TileParts/0102-TILEDAP/0102-TILEDAP_SCH.pdf

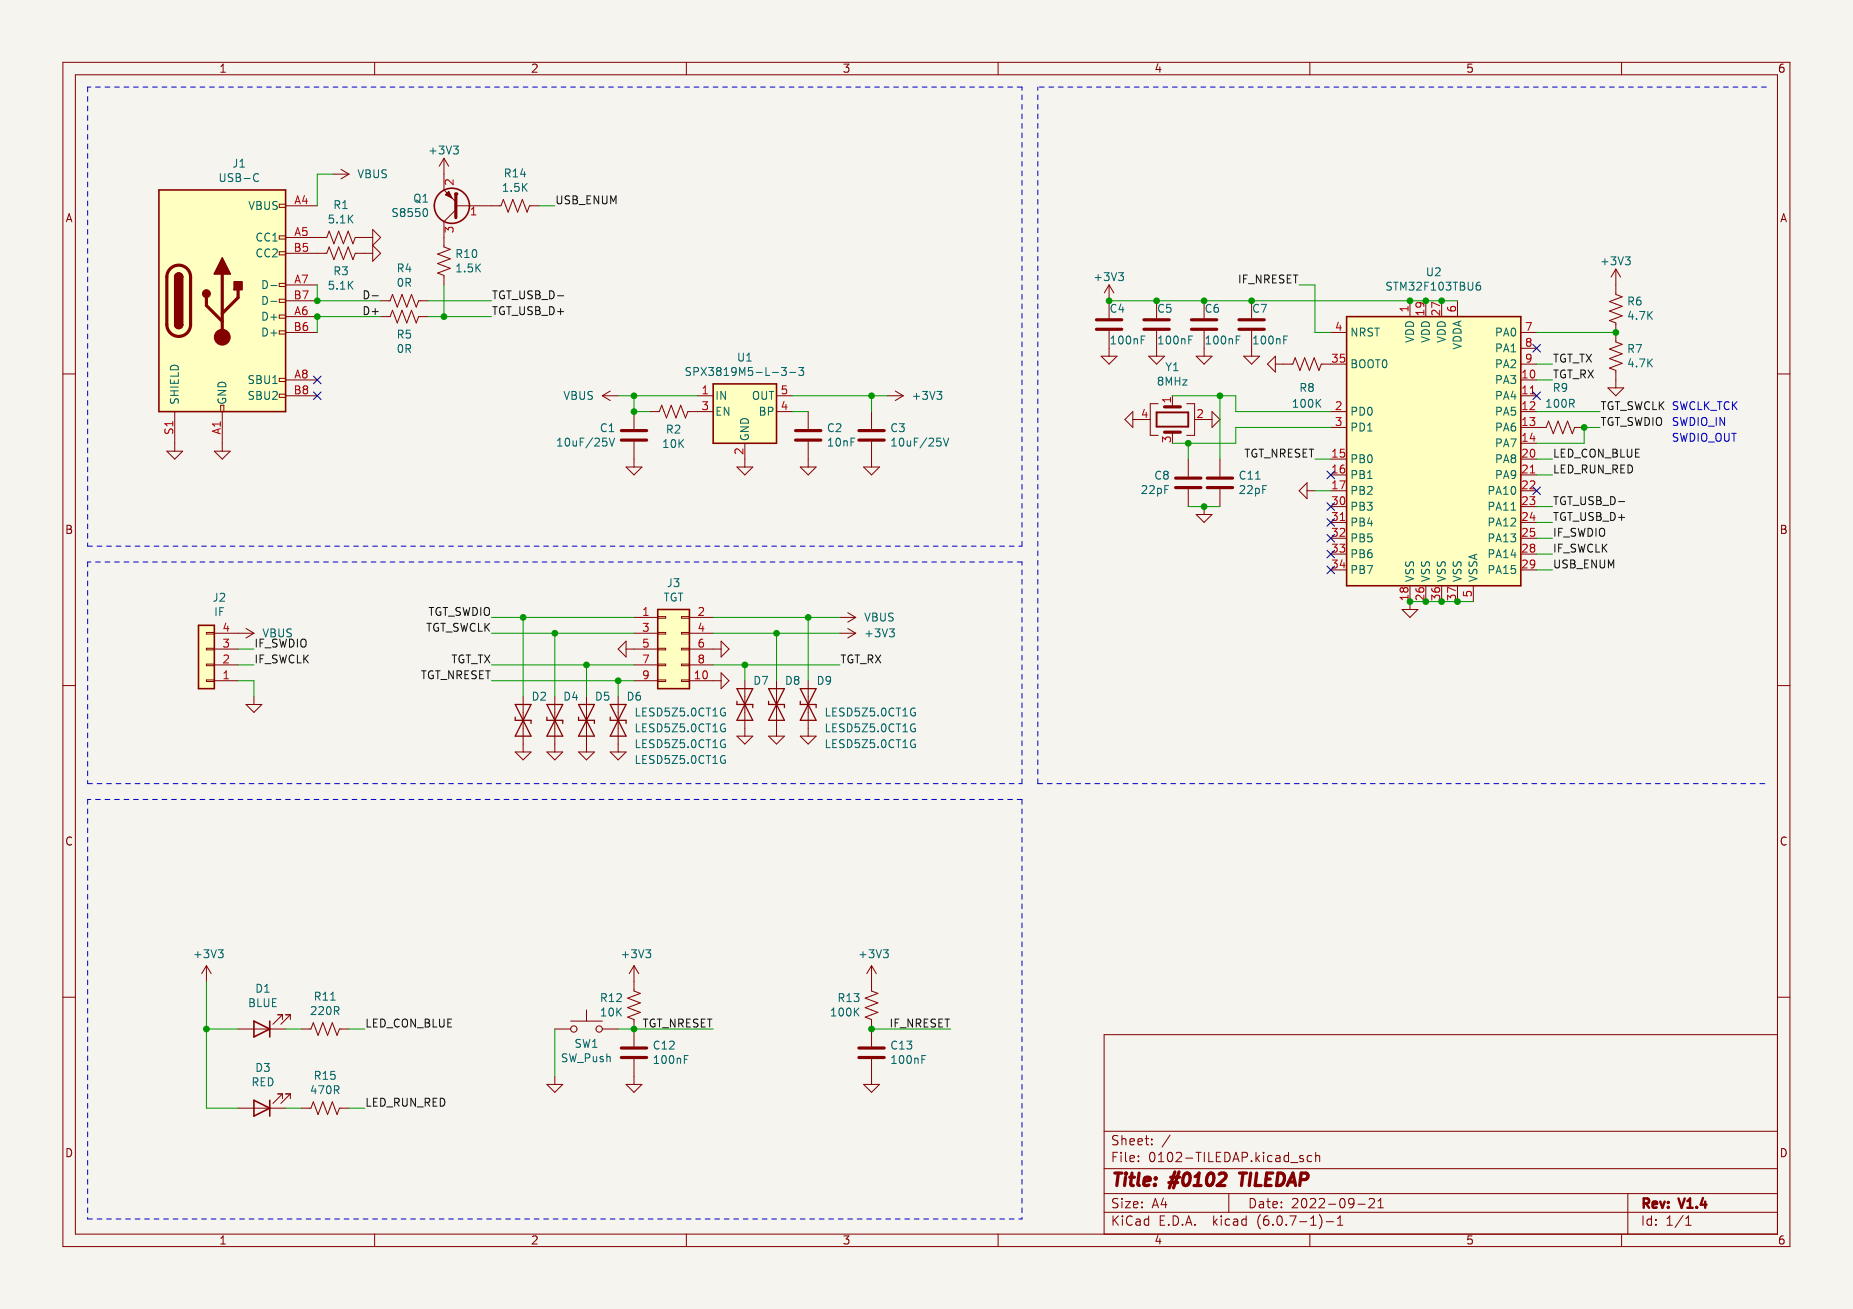
[picture p2: page 1]
