TileParts/0102-TILEDAP/0102-TILEDAP.kicad_pcb

## KiCad design 0102-TILEDAP.kicad_pcb (2022-09-22)

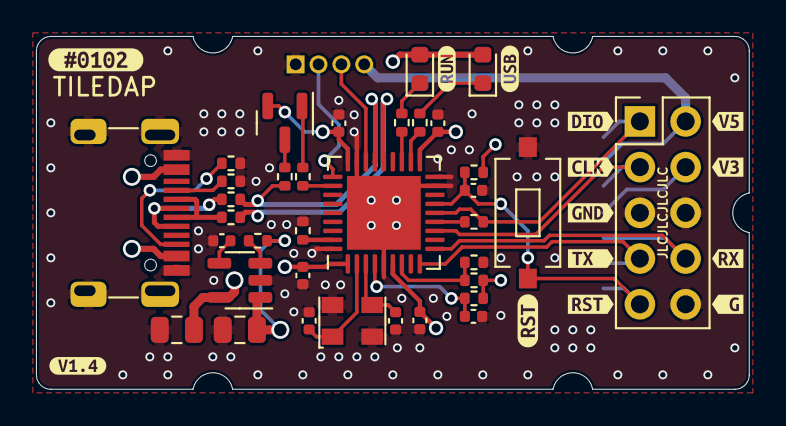
[picture p3: board 0102-TILEDAP.kicad_pcb from above]

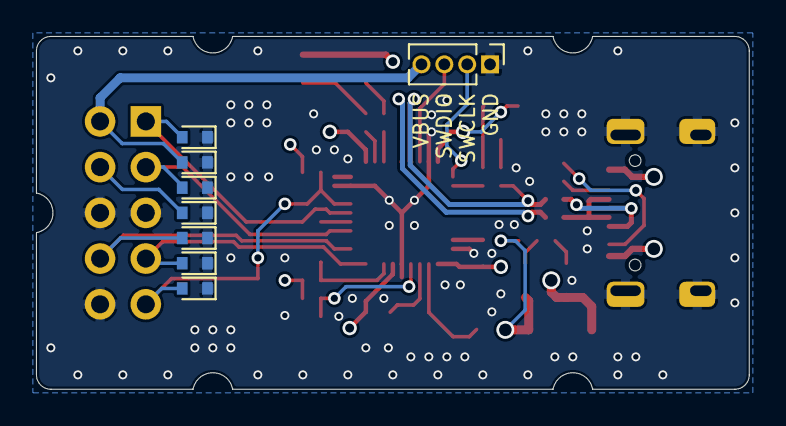
[picture p4: board 0102-TILEDAP.kicad_pcb from below]

Board: 4 copper layers, 39.6 x 19.6 mm, 57 parts (8 on the bottom side), 31 nets.

Parts:
C1, C3: 10uF/25V; C_0805_2012Metric
C2: 10nF; C_0402_1005Metric
C4, C5, C6, C7, C12, C13: 100nF; C_0402_1005Metric
C8, C11: 22pF; C_0402_1005Metric
D1: BLUE; LED_0603_1608Metric
D3: RED; LED_0603_1608Metric
D7: LESD5Z5.0CT1G; D_SOD-523
D?: LESD5Z5.0CT1G; D_SOD-523
D?#2, D?#3, D?#4, D?#5, D?#6: LESD5Z5.0CT1G; D_SOD-523
J1: USB-C; HRO_TYPE-C-31-M-12
J2: IF; PinHeader_1x04_P1.27mm_Vertical
J3: TGT; PinHeader_2x05_P2.54mm_Vertical
Q1: S8550; SOT-23
R1, R3: 5.1K; R_0402_1005Metric
R2, R12: 10K; R_0402_1005Metric
R4, R5: 0R; R_0402_1005Metric
R6, R7: 4.7K; R_0402_1005Metric
R8, R13: 100K; R_0402_1005Metric
R9: 100R; R_0402_1005Metric
R10, R14: 1.5K; R_0402_1005Metric
R11: 220R; R_0402_1005Metric
R15: 470R; R_0402_1005Metric
SW1: SW_Push; HCTL_TC-3601L-2.5
U1: SPX3819M5-L-3-3; SOT-23-5
U2: STM32F103TBU6; QFN-36-1EP_6x6mm_P0.5mm_EP4.1x4.1mm
Y1: 8MHz; Oscillator_SMD_3.2x2.5mm
kibuzzard-631DD70B: G***; kibuzzard-631DD70B
kibuzzard-631DD701: G***; kibuzzard-631DD701
kibuzzard-631DD707: G***; kibuzzard-631DD707
kibuzzard-631DDA4D: G***; kibuzzard-631DDA4D
kibuzzard-632A8CA6: G***; kibuzzard-632A8CA6
kibuzzard-632952D1: G***; kibuzzard-632952D1
kibuzzard-632952D9: G***; kibuzzard-632952D9
kibuzzard-632952DE: G***; kibuzzard-632952DE
kibuzzard-632952E3: G***; kibuzzard-632952E3
kibuzzard-632952EA: G***; kibuzzard-632952EA
kibuzzard-6329514A: G***; kibuzzard-6329514A
kibuzzard-63295172: G***; kibuzzard-63295172
kibuzzard-63295177: G***; kibuzzard-63295177
kibuzzard-63295187: G***; kibuzzard-63295187

Connections:
+3V3: C3.2, C4.2, C5.2, C6.2, C7.2, D1.2 (A), D3.2 (A), D?#4.2 (A2), J3.4, Q1.2 (E), R6.1, R12.2, R13.2, U1.5 (OUT), U2.1 (VDD), U2.6 (VDDA), U2.19 (VDD), U2.27 (VDD)
/D+: J1.A6 (D+), J1.B6 (D+), R5.2
/D-: J1.A7 (D-), J1.B7 (D-), R4.2
/IF_NRESET: C13.2, R13.1, U2.4 (NRST)
/IF_SWCLK: J2.2, U2.28 (PA14)
/IF_SWDIO: J2.3, U2.25 (PA13)
/LED_CON_BLUE: R11.1, U2.20 (PA8)
/LED_RUN_RED: R15.1, U2.21 (PA9)
/TGT_NRESET: C12.2, D?.2 (A2), J3.9, R12.1, SW1.2, U2.15 (PB0)
/TGT_RX: D7.2 (A2), J3.8, U2.10 (PA3)
/TGT_SWCLK: D?#2.2 (A2), J3.3, U2.12 (PA5)
/TGT_SWDIO: D?#6.2 (A2), J3.1, R9.1, U2.14 (PA7)
/TGT_TX: D?#5.2 (A2), J3.7, U2.9 (PA2)
/TGT_USB_D+: R5.1, R10.2, U2.24 (PA12)
/TGT_USB_D-: R4.1, U2.23 (PA11)
/USB_ENUM: R14.1, U2.29 (PA15)
GND: C1.1, C2.1, C3.1, C4.1, C5.1, C6.1, C7.1, C8.1, C11.1, C12.1, C13.1, D7.1 (A1), D?.1 (A1), D?#2.1 (A1), D?#3.1 (A1), D?#4.1 (A1), D?#5.1 (A1), D?#6.1 (A1), J1.A1 (GND), J1.A12 (GND), J1.B1 (GND), J1.B12 (GND), J1.S1 (SHIELD), J2.1, J3.5, J3.6, J3.10, R1.1, R3.1, R7.1, R8.2, SW1.1, U1.2 (GND), U2.5 (VSSA), U2.17 (PB2), U2.18 (VSS), U2.26 (VSS), U2.36 (VSS), U2.37 (VSS), Y1.2, Y1.4
unnamed: C2.2, U1.4 (BP)
unnamed: C8.2, U2.3 (PD1), Y1.3
unnamed: C11.2, U2.2 (PD0), Y1.1
unnamed: D1.1 (K), R11.2
unnamed: D3.1 (K), R15.2
unnamed: J1.A5 (CC1), R1.2
unnamed: J1.B5 (CC2), R3.2
unnamed: Q1.1 (B), R14.2
unnamed: Q1.3 (C), R10.1
unnamed: R2.1, U1.3 (EN)
unnamed: R6.2, R7.2, U2.7 (PA0)
unnamed: R8.1, U2.35 (BOOT0)
unnamed: R9.2, U2.13 (PA6)
VBUS: C1.2, D?#3.2 (A2), J1.A4 (VBUS), J1.A9 (VBUS), J1.B4 (VBUS), J1.B9 (VBUS), J2.4, J3.2, R2.2, U1.1 (IN)
