TileParts/0102-TILEDAP/(commit log)

2022-09-08 Add #0102 DAPLink
    [0102-TILEDAP.kicad_pcb, 0102-TILEDAP.sch]
2022-09-08 Update DAPLink to 4-layers
    [0102-TILEDAP.kicad_pcb]
2022-09-08 Finish DAPLink with final outline
    [0102-TILEDAP.kicad_pcb]
2022-09-08 Output gerber for DAPLink V1.0
    [0102-TILEDAP-Bottom_Cu.gbr, 0102-TILEDAP-Bottom_Mask.gbr, 0102-TILEDAP-Bottom_Paste.gbr, 0102-TILEDAP-Bottom_Silk.gbr, 0102-TILEDAP-EdgeCuts.gbr, 0102-TILEDAP-NPTH.drl, 0102-TILEDAP-PTH.drl, 0102-TILEDAP-Top_Cu.gbr]
2022-09-08 Import 3D models for DAPLink
    [0102-TILEDAP.kicad_pcb]
2022-09-08 Fix USB enumerate
    [0102-TILEDAP.kicad_pcb, 0102-TILEDAP.sch]
2022-09-08 Correct silks
    [0102-TILEDAP.kicad_pcb, 0102-TILEDAP.sch]
2022-09-08 Output gerber V1.1
    [0102-TILEDAP-Bottom_Cu.gbr, 0102-TILEDAP-Bottom_Mask.gbr, 0102-TILEDAP-Bottom_Paste.gbr, 0102-TILEDAP-Bottom_Silk.gbr, 0102-TILEDAP-EdgeCuts.gbr, 0102-TILEDAP-NPTH.drl, 0102-TILEDAP-PTH.drl, 0102-TILEDAP-Top_Cu.gbr]
2022-09-12 Migrate to KiCad 6
    [0102-TILEDAP.kicad_pcb, 0102-TILEDAP.kicad_sch, 0102-TILEDAP.sch]
2022-09-12 Rework silks
    [0102-TILEDAP.kicad_pcb]
2022-09-12 Fix models
    [0102-TILEDAP.kicad_pcb]
2022-09-12 Update gerber V1.2
    [0102-TILEDAP-Bottom_Cu.gbr, 0102-TILEDAP-Bottom_Mask.gbr, 0102-TILEDAP-Bottom_Paste.gbr, 0102-TILEDAP-Bottom_Silk.gbr, 0102-TILEDAP-EdgeCuts.gbr, 0102-TILEDAP-NPTH.drl, 0102-TILEDAP-PTH.drl, 0102-TILEDAP-Top_Cu.gbr]
2022-09-13 Refill copper to fix shield pin of USB-C connector
    [0102-TILEDAP.kicad_pcb]
2022-09-16 Fix USB_ENUM
    [0102-TILEDAP.kicad_pcb, 0102-TILEDAP.kicad_sch]
2022-09-16 Update resistor for LED_CON_BLUE
    [0102-TILEDAP.kicad_pcb, 0102-TILEDAP.kicad_sch]
2022-09-16 MFDoc V1.3
    [0102-TILEDAP-Bottom_Cu.gbr, 0102-TILEDAP-Bottom_Mask.gbr, 0102-TILEDAP-Bottom_Paste.gbr, 0102-TILEDAP-Bottom_Silk.gbr, 0102-TILEDAP-EdgeCuts.gbr, 0102-TILEDAP-NPTH.drl, 0102-TILEDAP-PTH.drl, 0102-TILEDAP-Top_Cu.gbr]
2022-09-22 Rework PCB
    * Use New boundary
    * Use laid USB-C connector
    * Add ESDs
    [0102-TILEDAP.kicad_pcb, 0102-TILEDAP.kicad_sch]
2022-09-22 MFDoc V1.4
    [0102-TILEDAP-Bottom_Cu.gbr, 0102-TILEDAP-Bottom_Mask.gbr, 0102-TILEDAP-Bottom_Paste.gbr, 0102-TILEDAP-Bottom_Silk.gbr, 0102-TILEDAP-EdgeCuts.gbr, 0102-TILEDAP-NPTH.drl, 0102-TILEDAP-PTH.drl, 0102-TILEDAP-Top_Cu.gbr]
2022-09-29 Fix duplicated properties of sch
    [0102-TILEDAP.kicad_sch]
